benkrasnow/Temperature_sensing_stirbar/PCB/TempBar V1/stirbar PCB layout.jpg

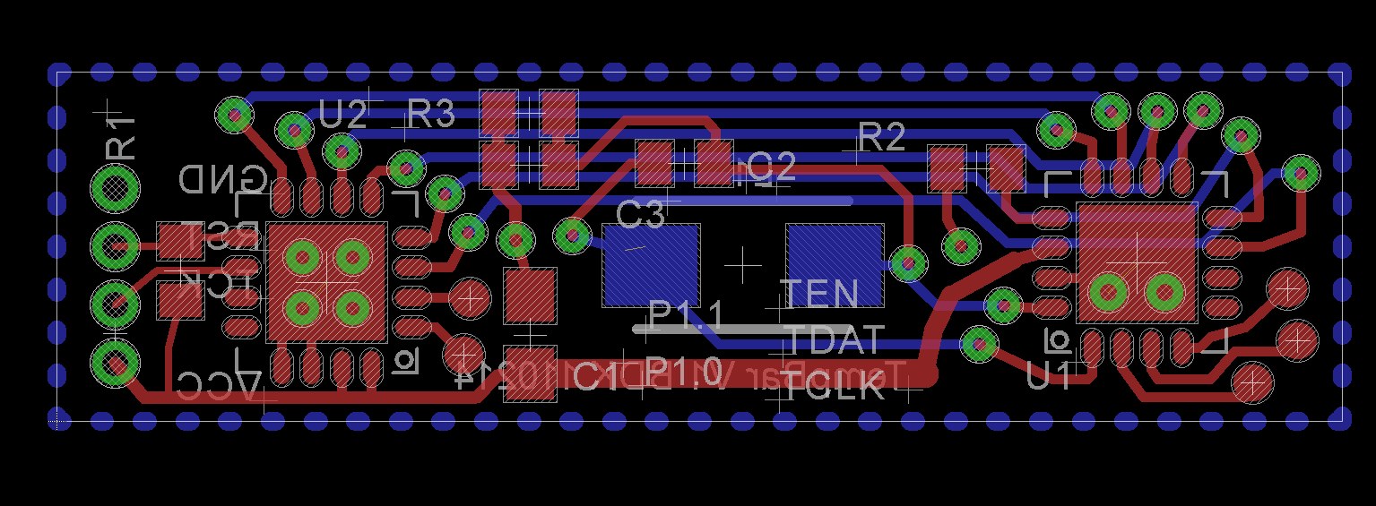
PCB/TempBar V1/stirbar PCB layout.jpg
