benkrasnow/Temperature_sensing_stirbar/README.md

# Temperature_sensing_stirbar
Schematics, PCB layout, and firmware for an RFID temperature sensor
https://youtu.be/nh1SIfipQs4
