benkrasnow/Temperature_sensing_stirbar/PCB/TempBar V1/eZ430-PaLFI-V1.1_Board.pdf

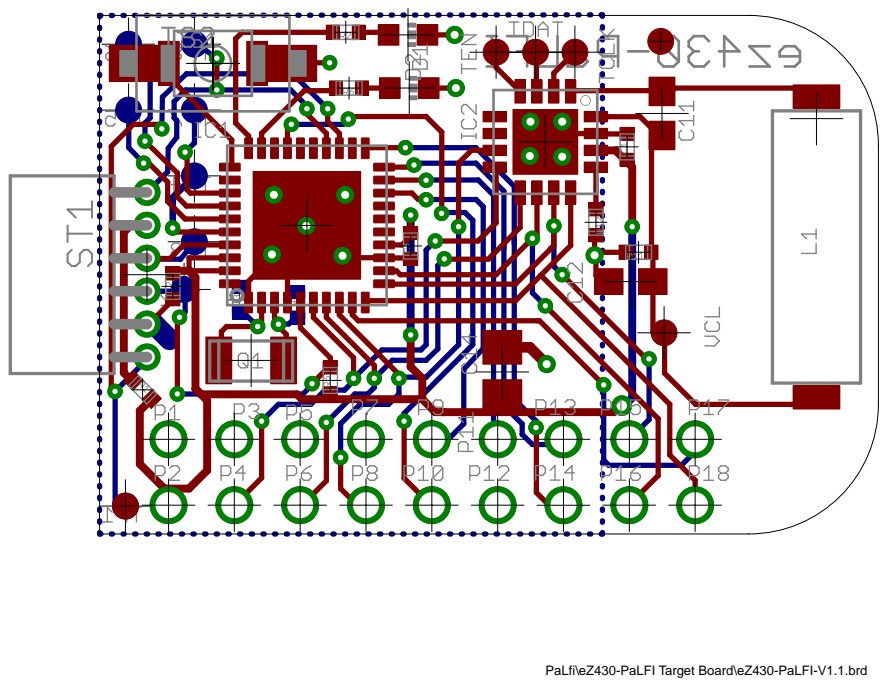
[picture p2: page 1]

28.05.2009 14:29:21 f=7.00 C:\Documents and Settings\a0746790\My Documents\Kostas\APPLICATION\LF\PaLfi\eZ430-PaLFI Target Board\eZ430-PaLFI-V1.1.brd
