benkrasnow/Temperature_sensing_stirbar/PCB/TempBar V1/eZ430-PaLFI-V1.1_Circuit.pdf

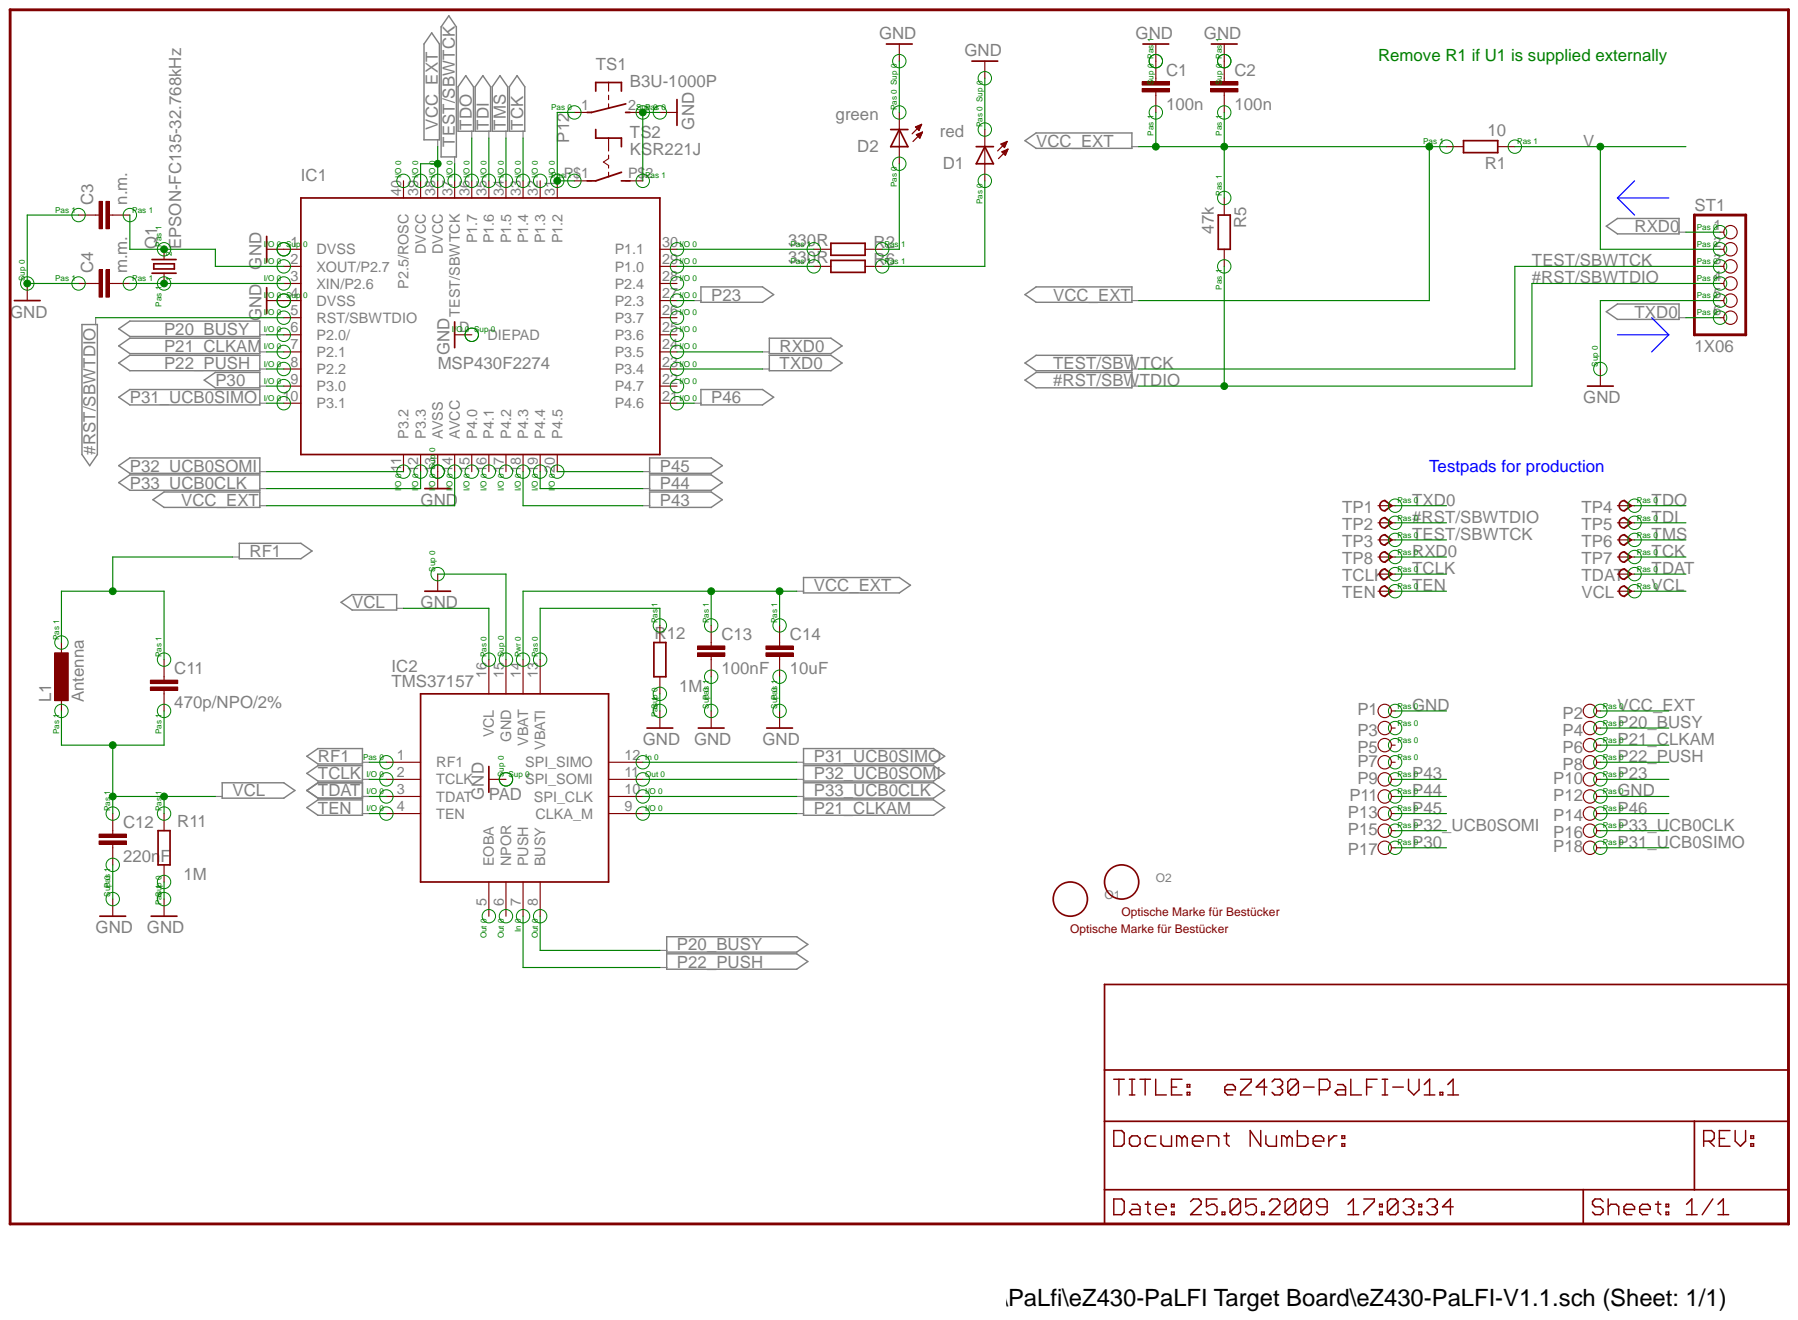
[picture p3: page 1]

Remove R1 if U1 is supplied externally

Pas 1 Pas 1

Optische Marke für Bestücker

28.05.2009 14:30:29 C:\Documents and Settings\a0746790\My Documents\Kostas\APPLICATION\LF\PaLfi\eZ430-PaLFI Target Board\eZ430-PaLFI-V1.1.sch (Sheet: 1/1)
