benkrasnow/Temperature_sensing_stirbar/PCB/TempBar V1/TempBar V1.pdf

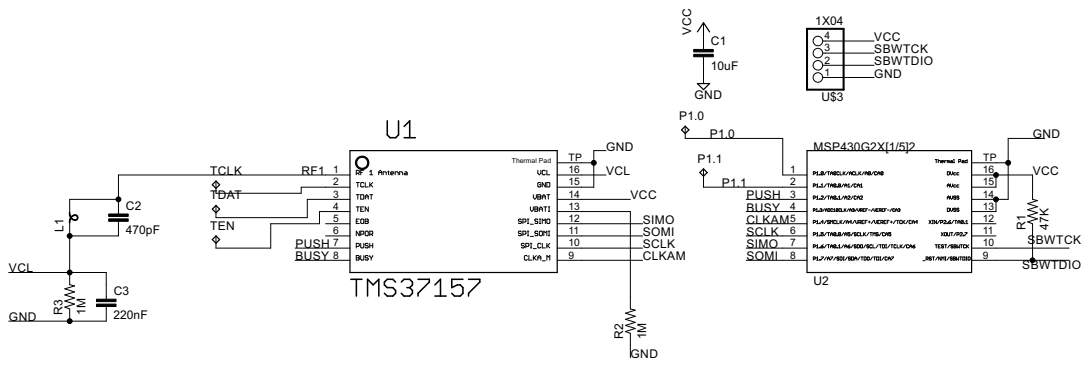
[picture p4: page 1]
