benkrasnow/Temperature_sensing_stirbar/PCB/TempBar V1/TempBar V1.brd

## EAGLE design PCB/TempBar V1/TempBar V1.brd (2023-04-10)

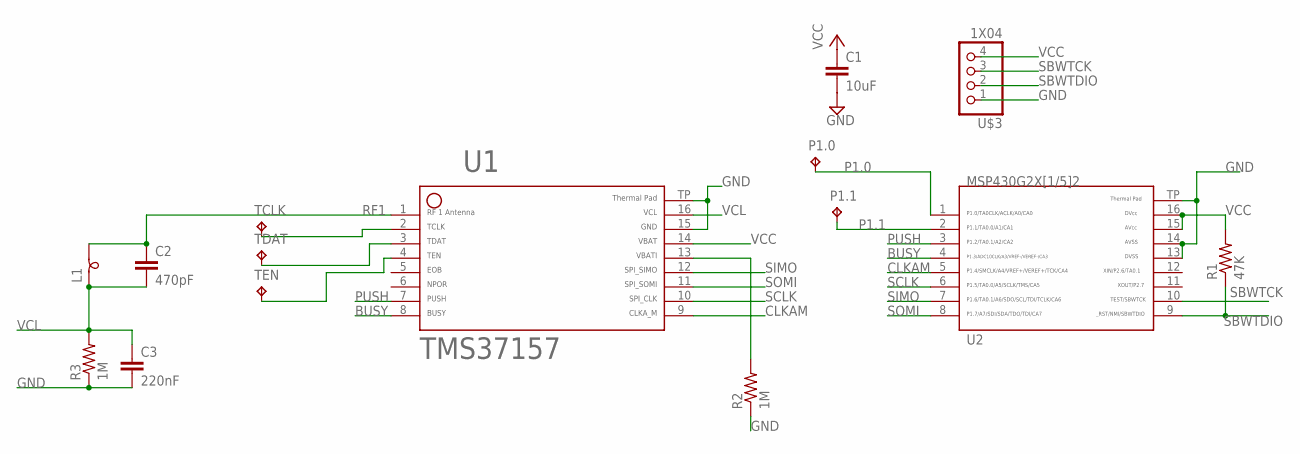
[picture p5: schematic TempBar V1.sch]

Parts:
C1: 10uF; C0603
C2: 470pF; C0402
C3: 220nF; C0402
L1: SM-B5
P1.0, P1.1: TPTP08R; TP08R
R1: 47K; R0402
R2, R3: 1M; R0402
TCLK: TPTP08R; TP08R
TDAT: TPTP08R; TP08R
TEN: TPTP08R; TP08R
U1: TMS37157; RSA16
U2: G2X[1/5]2---RSA16; RSA16
U$3: 1X04; 1X06

Connections:
BUSY: U1.8, U2.4
CLKAM: U1.9, U2.5
GND: C1.2, C3.2, R2.1, R3.1, U1.15, U1.TP (PP), U2.13, U2.14, U2.TP, U$3.1
unnamed: R2.2, U1.13
unnamed: TCLK.TP, U1.2
unnamed: TDAT.TP, U1.3
unnamed: TEN.TP, U1.4
P1.0: P1.0.TP, U2.1
P1.1: P1.1.TP, U2.2
PUSH: U1.7, U2.3
RF1: C2.1, L1.2, U1.1
SBWTCK: U2.10, U$3.3
SBWTDIO: R1.1, U2.9, U$3.2
SCLK: U1.10, U2.6
SIMO: U1.12, U2.7
SOMI: U1.11, U2.8
VCC: C1.1, R1.2, U1.14, U2.15, U2.16, U$3.4
VCL: C2.2, C3.1, L1.1, R3.2, U1.16

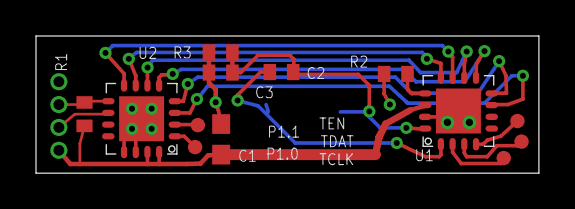
[picture p6: board TempBar V1.brd from above]

Board: 2 copper layers, 27.9 x 7.6 mm, 15 parts (1 on the bottom side), 18 nets.
